FabCode288/HSK-Mensabot/docs/source/packages/mensabot_utils/safety/safety_control_node.rst

Safety Control Node
===================

The ``SafetyControlNode`` is the central software safety component of the HSK-MensaBot. It supervises the current safety state of the robot by combining information from the safety laser scanners, the hardware interface and the emergency stop circuit.

Based on the current operating state, the node publishes speed limitations, emergency stop information and filtered velocity commands. In addition, it performs the automatic reset of the safety relay once all safety conditions have returned to a valid state.

Purpose
-------

The node performs the following safety-related tasks:

* Monitors the front and rear safety laser scanners.
* Evaluates warning and protective field violations.
* Supervises the hardware connection state.
* Monitors the emergency stop relay.
* Automatically resets the safety relay after a valid release.
* Limits the maximum driving speed inside warning fields.
* Stops all robot motion during emergency stop conditions.
* Publishes the current emergency stop state for other software components.

Subscribed Topics
-----------------

+---------------------------------+---------------------------------------------+-------------------------------------------------------------------------+
| Topic                           | Message Type                                | Description                                                             |
+=================================+=============================================+=========================================================================+
| ``/lidars/front/output_paths``  | ``sick_safetyscanners2_interfaces/OutputPaths`` | Front safety scanner monitoring information.                        |
+---------------------------------+---------------------------------------------+-------------------------------------------------------------------------+
| ``/lidars/rear/output_paths``   | ``sick_safetyscanners2_interfaces/OutputPaths`` | Rear safety scanner monitoring information.                         |
+---------------------------------+---------------------------------------------+-------------------------------------------------------------------------+
| ``/hardware/connected``         | ``std_msgs/Bool``                           | Indicates whether communication with the motor controller is available. |
+---------------------------------+---------------------------------------------+-------------------------------------------------------------------------+
| ``/cmd_vel``                    | ``geometry_msgs/Twist``                     | Incoming velocity commands generated by the navigation stack.           |
+---------------------------------+---------------------------------------------+-------------------------------------------------------------------------+

Published Topics
----------------

+----------------------+-----------------------------+------------------------------------------------------------+
| Topic                | Message Type                | Description                                                |
+======================+=============================+============================================================+
| ``/speed_limit``     | ``nav2_msgs/SpeedLimit``    | Current speed limitation used by the navigation stack.     |
+----------------------+-----------------------------+------------------------------------------------------------+
| ``/safety/estop``    | ``std_msgs/Bool``           | Current emergency stop state.                              |
+----------------------+-----------------------------+------------------------------------------------------------+
| ``/safety/cmd_vel``  | ``geometry_msgs/Twist``     | Safety-filtered velocity commands forwarded to the robot.  |
+----------------------+-----------------------------+------------------------------------------------------------+

Parameters
----------

+----------------+---------+-----------------------------------------------------------------------------------------+
| Parameter      | Default | Description                                                                             |
+================+=========+=========================================================================================+
| ``simulation`` | ``false`` | Enables simulation mode by disabling GPIO access and hardware-specific functionality. |
+----------------+---------+-----------------------------------------------------------------------------------------+

Related Documentation
---------------------

The overall safety architecture, hardware safety circuit and software safety concept are described in the project documentation.

Project Documentation

`Safety Documentation <https://github.com/FabCode288/HSK-Mensabot/blob/main/docs/safety/README.md>`_

Repository

`Safety Control Node <https://github.com/FabCode288/HSK-Mensabot/blob/main/src/mensabot_utils/mensabot_utils/safety_control_node.py>`_

API Reference
-------------

.. automodule:: mensabot_utils.safety_control_node
   :members:
   :undoc-members:
   :show-inheritance:
