FabCode288/HSK-Mensabot/docs/source/index.rst

.. Mensabot documentation master file, created by
   sphinx-quickstart on Wed Jul 29 22:39:57 2026.
   You can adapt this file completely to your liking, but it should at least
   contain the root `toctree` directive.

Mensabot Documentation
======================

Welcome to the documentation of the HSK-Mensabot project.

This documentation contains the project description and launch files as well as the complete Python and C++ API documentation.



   Overview of the Mensabot in the simulation environment.



   Overview of the Mensabot in the real environment.

.. toctree::
   :maxdepth: 2
   :caption: User Guide

   user_guide
   introduction
   installation
   quick_start
   architecture

.. toctree::
   :maxdepth: 2
   :caption: API Reference

   api_reference
   packages/index

.. toctree::
   :maxdepth: 2
   :caption: Developer Guide

   developer_guide
   repository
   build
   documentation
