FabCode288/HSK-Mensabot/src/sick_safetyscanners2/docs/images/safetyscanners.png

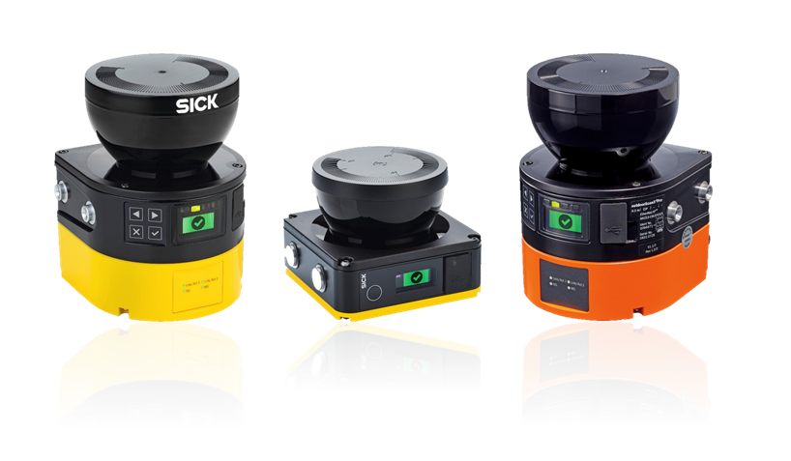
src/sick_safetyscanners2/docs/images/safetyscanners.png
