FabCode288/HSK-Mensabot/src/sick_safetyscanners_base/docs/images/safetyscanners.png

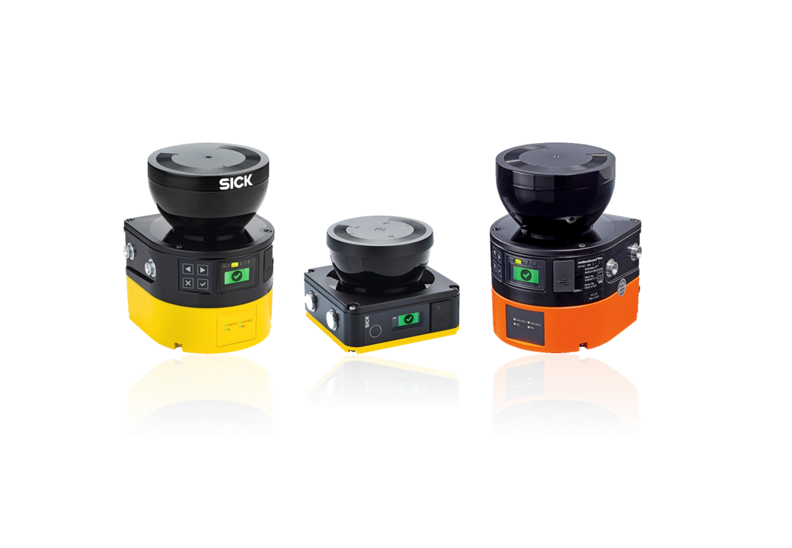
src/sick_safetyscanners_base/docs/images/safetyscanners.png
