FabCode288/HSK-Mensabot/src/sick_safetyscanners2/description/meshes/NANS3_collision.stl

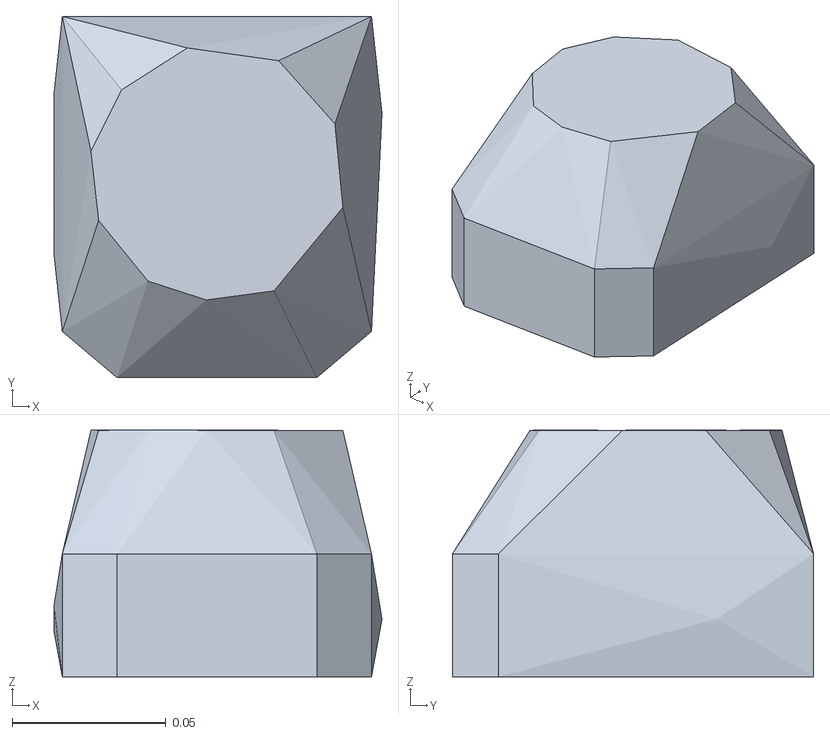
[picture p57: CAD file, 2026-05-12]
src/sick_safetyscanners2/description/meshes/NANS3_collision.stl
0.107 x 0.117 x 0.0802
