FabCode288/HSK-Mensabot/src/sick_safetyscanners2/description/meshes/MountingKit_2a_collision.stl

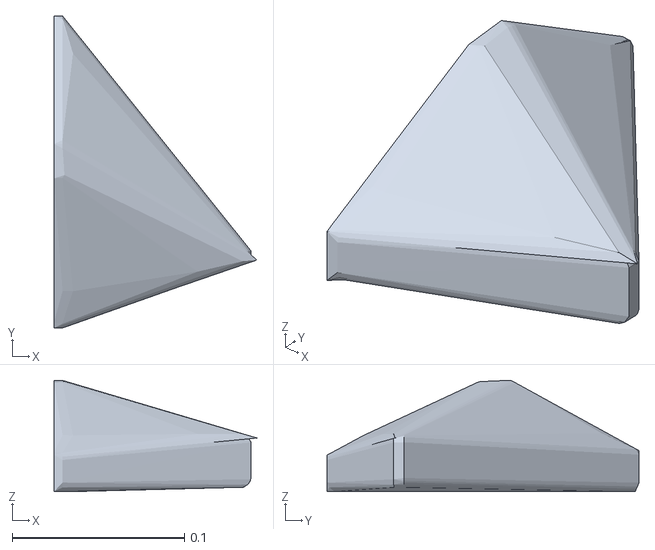
[picture p58: CAD file, 2026-05-12]
src/sick_safetyscanners2/description/meshes/MountingKit_2a_collision.stl
0.118 x 0.181 x 0.0645
