FabCode288/HSK-Mensabot/docs/images/tf_tree.pdf

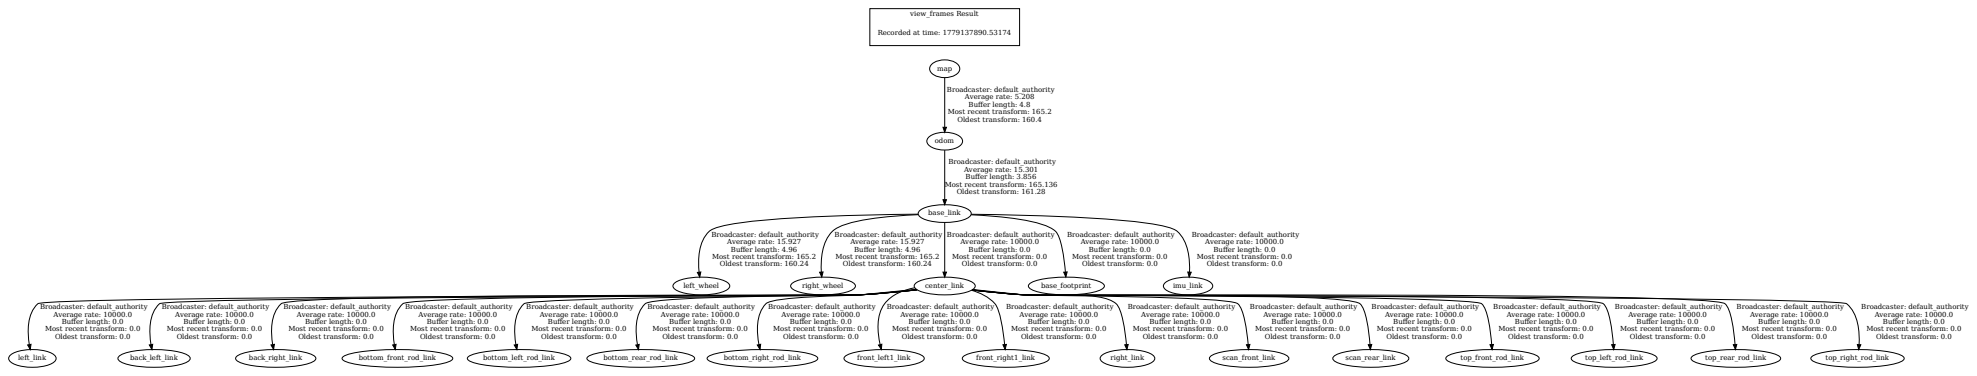
[picture p59: page 1]
view_frames Result; base_link; left_wheel; right_wheel; center_link; base_footprint; imu_link; odom; left_link; back_left_link; back_right_link; bottom_front_rod_link; bottom_left_rod_link; bottom_rear_rod_link; bottom_right_rod_link; front_left1_link; front_right1_link; right_link; scan_front_link; scan_rear_link; top_front_rod_link; top_left_rod_link; top_rear_rod_link; top_right_rod_link; map

Recorded at time: 1779137890.53174

Broadcaster: default_authority
Average rate: 5.208
Buffer length: 4.8
Most recent transform: 165.2
Oldest transform: 160.4

Average rate: 15.301
Buffer length: 3.856
Most recent transform: 165.136
Oldest transform: 161.28

Average rate: 15.927
Buffer length: 4.96
Oldest transform: 160.24

Average rate: 10000.0
Buffer length: 0.0
Most recent transform: 0.0
Oldest transform: 0.0
