FabCode288/HSK-Mensabot/src/mensabot_navigation/config/navigation.yaml

bt_navigator:
  ros__parameters:
    global_frame: map
    robot_base_frame: base_footprint # changed from base_footprint
    odom_topic: /odom
    bt_loop_duration: 10
    default_server_timeout: 20
    wait_for_service_timeout: 1000
    action_server_result_timeout: 900.0
    navigators: ["navigate_to_pose", "navigate_through_poses"]
    navigate_to_pose:
      plugin: "nav2_bt_navigator::NavigateToPoseNavigator"
    navigate_through_poses:
      plugin: "nav2_bt_navigator::NavigateThroughPosesNavigator"

    error_code_names:
      - compute_path_error_code
      - follow_path_error_code

controller_server:
  ros__parameters:
    controller_frequency: 20.0
    costmap_update_timeout: 0.30
    min_x_velocity_threshold: 0.001
    min_y_velocity_threshold: 0.0 
    min_theta_velocity_threshold: 0.001
    speed_limit_topic: "/speed_limit"
    failure_tolerance: 0.3
    progress_checker_plugins: ["progress_checker"]
    goal_checker_plugins: ["general_goal_checker"] # "precise_goal_checker"
    controller_plugins: ["FollowPath"]
    use_realtime_priority: false

    # Progress checker parameters
    progress_checker:
      plugin: "nav2_controller::SimpleProgressChecker"
      required_movement_radius: 0.1 #changed from 0.05 #1.0
      movement_time_allowance: 20.0 #changed from 30.0 #12.0

    general_goal_checker:
      stateful: True
      plugin: "nav2_controller::SimpleGoalChecker"
      xy_goal_tolerance: 0.10 #changed from 0.15
      yaw_goal_tolerance: 0.10 #changed from 0.15

    # MPPI parameters
    FollowPath:
      plugin: "nav2_mppi_controller::MPPIController"
      time_steps: 100 #80
      model_dt: 0.05
      batch_size: 1000 #800 #2000 @ 30 Hz or 1000 @ 50 Hz are good values
      ax_max: 4.0 #m/s^2
      ax_min: -4.0 #m/s^2
      ay_max: 0.0 #No motion in y direction
      az_max: 4.0 #No motion in z direction
      vx_std: 0.2
      vy_std: 0.2
      wz_std: 0.2 
      vx_max: 0.5 #m/s
      vx_min: -0.5 #m/s
      vy_max: 0.0 #No motion in y direction
      wz_max: 0.5 #rad/s
      iteration_count: 1
      prune_distance: 1.7
      transform_tolerance: 0.1
      temperature: 0.3
      gamma: 0.015 #Usually not needed to change gamma
      motion_model: "DiffDrive"
      visualize: true #turn false for better performance, true for debugging
      regenerate_noises: true
      open_loop: false #false for using odometry feedback, true for using last command velocities as input to the model
      TrajectoryVisualizer:
        trajectory_step: 5
        time_step: 3
      critics: [
        "ConstraintCritic", "CostCritic", "GoalCritic",
        "GoalAngleCritic", "PathAlignCritic", "PathFollowCritic",
        "PathAngleCritic", "PreferForwardCritic"]
      ConstraintCritic:
        enabled: true
        cost_power: 1
        cost_weight: 4.0
      GoalCritic:
        enabled: true
        cost_power: 2 #1
        cost_weight: 6.0
        threshold_to_consider: 2.0
      GoalAngleCritic:
        enabled: true
        cost_power: 1
        cost_weight: 4.0
        threshold_to_consider: 0.8 #0.8
      PreferForwardCritic:
        enabled: true
        cost_power: 1
        cost_weight: 8.0 #5
        threshold_to_consider: 0.5
      CostCritic:
        enabled: true
        cost_power: 1
        cost_weight: 3.81
        critical_cost: 300.0
        consider_footprint: true
        collision_cost: 1000000.0
        near_goal_distance: 0.5 #1.0
        trajectory_point_step: 2
      PathAlignCritic:
        enabled: true
        cost_power: 1
        cost_weight: 14.0
        max_path_occupancy_ratio: 0.05
        trajectory_point_step: 4
        threshold_to_consider: 0.5
        offset_from_furthest: 20
        use_path_orientations: false
      PathFollowCritic:
        enabled: true
        cost_power: 1
        cost_weight: 5.0
        offset_from_furthest: 6
        threshold_to_consider: 2.0
      PathAngleCritic:
        enabled: true
        cost_power: 1
        cost_weight: 2.0
        offset_from_furthest: 4
        threshold_to_consider: 0.5
        max_angle_to_furthest: 1.0
        mode: 0
      VelocityDeadbandCritic:
         enabled: true
         cost_power: 1
         cost_weight: 35.0
         deadband_velocities: [0.5, 0.0, 0.5]
      # TwirlingCritic:
      #   enabled: true
      #   twirling_cost_power: 1
      #   twirling_cost_weight: 10.0

local_costmap:
  local_costmap:
    ros__parameters:
      update_frequency: 5.0
      publish_frequency: 2.0
      global_frame: odom
      robot_base_frame: base_footprint
      rolling_window: true
      width: 5
      height: 5 
      resolution: 0.05
      footprint: "[ [0.2, 0.35], [0.2, -0.35], [-0.65, -0.35], [-0.65, 0.35] ]"
      plugins: ["voxel_layer", "inflation_layer"]
      inflation_layer:
        plugin: "nav2_costmap_2d::InflationLayer"
        cost_scaling_factor: 3.0
        inflation_radius: 1.2
      voxel_layer:
        plugin: "nav2_costmap_2d::VoxelLayer"
        enabled: True
        publish_voxel_map: True
        origin_z: 0.0
        z_resolution: 0.05
        z_voxels: 16
        max_obstacle_height: 2.0
        mark_threshold: 0
        observation_sources: scan
        scan:
          topic: /merged_scan
          max_obstacle_height: 2.0
          clearing: True
          marking: True
          data_type: "LaserScan"
          raytrace_max_range: 5.0
          raytrace_min_range: 0.0
          obstacle_max_range: 4.5
          obstacle_min_range: 0.0
      static_layer:
        plugin: "nav2_costmap_2d::StaticLayer"
        map_subscribe_transient_local: True
      always_send_full_costmap: True

global_costmap:
  global_costmap:
    ros__parameters:
      update_frequency: 1.0
      publish_frequency: 1.0
      global_frame: map
      robot_base_frame: base_footprint
      footprint: "[ [0.2, 0.35], [0.2, -0.35], [-0.65, -0.35], [-0.65, 0.35] ]"
      resolution: 0.05
      track_unknown_space: true
      plugins: ["static_layer", "obstacle_layer", "inflation_layer"]
      obstacle_layer:
        plugin: "nav2_costmap_2d::ObstacleLayer"
        enabled: True
        observation_sources: scan
        scan:
          topic: /merged_scan
          max_obstacle_height: 2.0
          clearing: True
          marking: True
          data_type: "LaserScan"
          raytrace_max_range: 5.0
          raytrace_min_range: 0.0
          obstacle_max_range: 4.5
          obstacle_min_range: 0.0
      static_layer:
        plugin: "nav2_costmap_2d::StaticLayer"
        map_subscribe_transient_local: True
      inflation_layer:
        plugin: "nav2_costmap_2d::InflationLayer"
        cost_scaling_factor: 3.0
        inflation_radius: 1.2
      always_send_full_costmap: True


planner_server:
  ros__parameters:
    expected_planner_frequency: 20.0
    planner_plugins: ["GridBased"]
    costmap_update_timeout: 1.0
    GridBased:
      plugin: "nav2_navfn_planner::NavfnPlanner"
      tolerance: 0.5
      use_astar: false
      allow_unknown: true

smoother_server:
  ros__parameters:
    smoother_plugins: ["simple_smoother"]
    simple_smoother:
      plugin: "nav2_smoother::SimpleSmoother"
      tolerance: 1.0e-10
      max_its: 1000
      do_refinement: True

behavior_server:
  ros__parameters:
    local_costmap_topic: local_costmap/costmap_raw
    global_costmap_topic: global_costmap/costmap_raw
    local_footprint_topic: local_costmap/published_footprint
    global_footprint_topic: global_costmap/published_footprint
    cycle_frequency: 10.0
    behavior_plugins: ["spin", "backup", "drive_on_heading", "assisted_teleop", "wait"]
    spin:
      plugin: "nav2_behaviors::Spin"
      max_rotational_vel: 0.5
      min_rotational_vel: 0.05
      rotational_acc_lim: 0.5
      enable_stamped_cmd_vel: true 
    backup:
      plugin: "nav2_behaviors::BackUp"
    drive_on_heading:
      plugin: "nav2_behaviors::DriveOnHeading"
    wait:
      plugin: "nav2_behaviors::Wait"
    assisted_teleop:
      plugin: "nav2_behaviors::AssistedTeleop"
    local_frame: odom
    global_frame: map
    robot_base_frame: base_footprint
    transform_tolerance: 0.1
    simulate_ahead_time: 2.0
    max_rotational_vel: 1.0
    min_rotational_vel: 0.4
    rotational_acc_lim: 3.2

waypoint_follower:
  ros__parameters:
    loop_rate: 20
    stop_on_failure: false
    action_server_result_timeout: 900.0
    waypoint_task_executor_plugin: "wait_at_waypoint"
    wait_at_waypoint:
      plugin: "nav2_waypoint_follower::WaitAtWaypoint"
      enabled: True
      waypoint_pause_duration: 200

velocity_smoother:
  ros__parameters:
    smoothing_frequency: 20.0
    scale_velocities: False
    feedback: "OPEN_LOOP"
    max_velocity: [0.5, 0.0, 0.5]
    min_velocity: [-0.5, 0.0, -0.5]
    max_accel: [0.4, 0.0, 0.8]
    max_decel: [-0.6, 0.0, -0.8]
    odom_topic: "odom"
    odom_duration: 0.1
    deadband_velocity: [0.0, 0.0, 0.0]
    velocity_timeout: 1.0

collision_monitor:
  ros__parameters:
    base_frame_id: "base_footprint" #changed from base_footprint
    odom_frame_id: "odom"
    cmd_vel_in_topic: "cmd_vel_smoothed"
    cmd_vel_out_topic: "cmd_vel"
    state_topic: "collision_monitor_state"
    transform_tolerance: 0.2
    source_timeout: 1.0
    base_shift_correction: True
    stop_pub_timeout: 2.0
    # Polygons represent zone around the robot for "stop", "slowdown" and "limit" action types,
    # and robot footprint for "approach" action type.
    polygons: ["FootprintApproach"]
    FootprintApproach:
      type: "polygon"
      action_type: "approach"
      footprint_topic: "/local_costmap/published_footprint"
      time_before_collision: 1.2
      simulation_time_step: 0.1
      min_points: 6
      visualize: False
      enabled: True
    observation_sources: ["scan"]
    scan:
      type: "scan"
      topic: "/merged_scan" # changed from "merged_scan"
      min_height: 0.15
      max_height: 2.0
      enabled: True

docking_server:
  ros__parameters:
    controller_frequency: 50.0
    initial_perception_timeout: 5.0
    wait_charge_timeout: 5.0
    dock_approach_timeout: 30.0
    undock_linear_tolerance: 0.05
    undock_angular_tolerance: 0.1
    max_retries: 3
    base_frame: "base_footprint"
    fixed_frame: "odom"
    dock_backwards: false
    dock_prestaging_tolerance: 0.5

    # Types of docks
    dock_plugins: ['simple_charging_dock']
    simple_charging_dock:
      plugin: 'opennav_docking::SimpleChargingDock'
      docking_threshold: 0.05
      staging_x_offset: -0.7
      use_external_detection_pose: true
      use_battery_status: false # true
      use_stall_detection: false # true

      external_detection_timeout: 1.0
      external_detection_translation_x: -0.18
      external_detection_translation_y: 0.0
      external_detection_rotation_roll: -1.57
      external_detection_rotation_pitch: -1.57
      external_detection_rotation_yaw: 0.0
      filter_coef: 0.1

    controller:
      k_phi: 3.0
      k_delta: 2.0
      v_linear_min: 0.15
      v_linear_max: 0.15
