FabCode288/HSK-Mensabot/src/mensabot_utils/mensabot_utils/lidar_field_selection_node.py

#!/usr/bin/env python3

"""
Selects the active LiDAR monitoring field based on the robot's motion state.

The node evaluates the commanded robot motion, selects the corresponding
LiDAR monitoring field, updates the GPIO outputs for the safety scanner and
publishes the matching Nav2 footprint.
"""

import rclpy
from rclpy.node import Node

from geometry_msgs.msg import TwistStamped, Polygon, Point32
from std_msgs.msg import String
from std_msgs.msg import Bool

from enum import Enum


class FieldState(Enum):
    """
    Enumeration of all supported LiDAR monitoring states.
    """

    STOP = 0

    FORWARD = 1
    BACKWARD = 2

    ROTATE_LEFT = 3
    ROTATE_RIGHT = 4

    MANUAL_OVERRIDE = 5


class LidarFieldSelector(Node):
    """
    ROS 2 node for selecting LiDAR monitoring fields.

    The node determines the robot's current motion state from velocity commands,
    controls the LiDAR field selection via GPIO outputs and updates the dynamic
    Nav2 footprint accordingly.
    """

    def __init__(self):
        """
        Initialize parameters, GPIO interfaces, ROS interfaces and internal state.
        """
        super().__init__('lidar_field_selector')

        # ============================================================
        # PARAMETERS
        # ============================================================

        self.declare_parameter('simulation', True)

        self.simulation = self.get_parameter(
            'simulation'
        ).get_parameter_value().bool_value

        # ============================================================
        # GPIO CONFIG
        # ============================================================

        self.gpio_pins = [22, 23, 24, 25, 26, 27]
        self.gpio_available = False

        self.gpio_requests = {}

        # Import GPIO ONLY on Raspberry Pi / real robot
        if not self.simulation:

            try:

                import gpiod  # type: ignore
                from gpiod.line import Direction, Value  # type: ignore

                self.gpiod = gpiod
                self.Direction = Direction
                self.Value = Value

                self.gpio_chip_path = "/dev/gpiochip4"

                for pin in self.gpio_pins:

                    gpio_request = self.gpiod.request_lines(
                        self.gpio_chip_path,
                        consumer="lidar_field_selector",
                        config={
                            pin:
                            self.gpiod.LineSettings(
                                direction=self.Direction.OUTPUT
                            )
                        }
                    )

                    self.gpio_requests[pin] = gpio_request

                    # Initialize HIGH
                    gpio_request.set_value(
                        pin,
                        self.Value.ACTIVE
                    )

                self.gpio_available = True

                self.get_logger().info(
                    'GPIO initialized'
                )

            except Exception as e:

                self.get_logger().error(
                    f'GPIO initialization failed: {e}'
                )

        else:

            self.get_logger().info(
                'Simulation mode active -> GPIO disabled'
            )

        # ============================================================
        # CONFIG
        # ============================================================

        self.linear_threshold = 0.02
        self.angular_threshold = 0.05

        self.timeout_sec = 0.5

        self.manual_override_timeout_sec = 2.0

        # ============================================================
        # FOOTPRINT CONFIGURATION
        # ============================================================

        # Original robot footprint:
        #
        # Front:  x =  0.20 m
        # Rear:   x = -0.65 m
        # Left:   y =  0.35 m
        # Right:  y = -0.35 m
        #
        # The following footprints include the additional safety
        # distances for the corresponding lidar monitoring case.

        self.footprints = {

            # --------------------------------------------------------
            # FORWARD
            #
            # Front: +300 mm
            # Rear:  +200 mm
            # Left:  +100 mm
            # Right: +100 mm
            # --------------------------------------------------------

            FieldState.FORWARD: [
                [0.55, 0.45],
                [0.55, -0.45],
                [-0.80, -0.45],
                [-0.80, 0.45],
            ],

            # --------------------------------------------------------
            # BACKWARD
            #
            # Front: +200 mm
            # Rear:  +300 mm
            # Left:  +100 mm
            # Right: +100 mm
            # --------------------------------------------------------

            FieldState.BACKWARD: [
                [0.40, 0.45],
                [0.40, -0.45],
                [-1.0, -0.45],
                [-1.0, 0.45],
            ],

            # --------------------------------------------------------
            # ROTATE LEFT
            #
            # Base extension:
            # Front: +200 mm
            # Rear:  +200 mm
            # Left:  +100 mm
            # Right: +100 mm
            #
            # Additional extension at rear right:
            # Right rear corner: -300 mm additional
            # --------------------------------------------------------

            FieldState.ROTATE_LEFT: [
                [0.40, -0.45],
                [0.40, 0.45],
                [0.00, 0.45],
                [-0.40, 0.75],
                [-0.85, 0.25],
                [-0.85, -0.45],
            ],

            # --------------------------------------------------------
            # ROTATE RIGHT
            #
            # Base extension:
            # Front: +200 mm
            # Rear:  +200 mm
            # Left:  +100 mm
            # Right: +100 mm
            #
            # Additional extension at rear left:
            # Left rear corner: +300 mm additional
            # --------------------------------------------------------

            FieldState.ROTATE_RIGHT: [
                [0.40, 0.45],
                [0.40, -0.45],
                [0.00, -0.45],
                [-0.70, -0.75],
                [-0.85, -0.25],
                [-0.85, 0.45],
            ],

            # --------------------------------------------------------
            # STOP
            #
            # Front: +200 mm
            # Rear:  +200 mm
            # Left:  +100 mm
            # Right: +100 mm
            # --------------------------------------------------------

            FieldState.STOP: [
                [0.40, 0.45],
                [0.40, -0.45],
                [-0.85, -0.45],
                [-0.85, 0.45],
            ],

            # --------------------------------------------------------
            # MANUAL OVERRIDE
            #
            # Uses STOP footprint for Nav2 collision checking.
            # --------------------------------------------------------

            FieldState.MANUAL_OVERRIDE: [
                [0.40, 0.45],
                [0.40, -0.45],
                [-0.85, -0.45],
                [-0.85, 0.45],
            ],
        }

        # ============================================================
        # STATE
        # ============================================================

        self.current_state = FieldState.STOP

        self.last_cmd_time = self.get_clock().now()

        self.manual_override_active = False

        self.last_manual_override_msg_time = self.get_clock().now()

        # ============================================================
        # ROS INTERFACES
        # ============================================================

        self.cmd_vel_sub = self.create_subscription(
            TwistStamped,
            '/mensabot_base_controller/cmd_vel_out',
            self.cmd_vel_callback,
            10
        )

        self.manual_override_sub = self.create_subscription(
            Bool,
            '/safety/manual_override',
            self.manual_override_callback,
            10
        )

        self.field_state_pub = self.create_publisher(
            String,
            '/safety/field_state',
            10
        )

        # Dynamic Nav2 local costmap footprint
        self.footprint_pub = self.create_publisher(
            Polygon,
            '/local_costmap/footprint',
            10
        )

        self.timer = self.create_timer(
            0.1,
            self.timer_callback
        )

        self.get_logger().info(
            'Lidar field selector started'
        )

        # Publish initial state
        self.publish_state()

        # Set initial lidar monitoring field
        self.set_gpio_state()

        # Publish initial STOP footprint
        self.publish_footprint()

    # ============================================================
    # MANUAL OVERRIDE CALLBACK
    # ============================================================

    def manual_override_callback(self, msg: Bool):
        """
        Handle manual override requests.

        Args:
            msg: Manual override state.
        """

        self.last_manual_override_msg_time = self.get_clock().now()

        previous_state = self.manual_override_active

        self.manual_override_active = msg.data

        if self.manual_override_active and not previous_state:

            self.get_logger().warn(
                'MANUAL OVERRIDE ACTIVE'
            )

        if self.manual_override_active:

            if self.current_state != FieldState.MANUAL_OVERRIDE:

                self.current_state = FieldState.MANUAL_OVERRIDE

                self.publish_state()

                self.set_gpio_state()

                self.publish_footprint()

    # ============================================================
    # CMD VEL CALLBACK
    # ============================================================

    def cmd_vel_callback(self, msg: TwistStamped):
        """
        Process commanded robot velocities and update the active monitoring field.

        Args:
            msg: Commanded robot velocity.
        """

        self.last_cmd_time = self.get_clock().now()

        if self.manual_override_active:
            return

        linear_x = msg.twist.linear.x
        angular_z = msg.twist.angular.z

        # Deadband
        if abs(linear_x) < self.linear_threshold:
            linear_x = 0.0

        if abs(angular_z) < self.angular_threshold:
            angular_z = 0.0

        new_state = self.determine_state(
            linear_x,
            angular_z
        )

        # Only switch field and footprint if state changed
        if new_state != self.current_state:

            self.current_state = new_state

            self.publish_state()

            self.set_gpio_state()

            self.publish_footprint()

    # ============================================================
    # DETERMINE STATE
    # ============================================================

    def determine_state(
        self,
        linear_x: float,
        angular_z: float
    ) -> FieldState:
        """
        Determine the LiDAR monitoring state from the commanded motion.

        Args:
            linear_x: Linear velocity in x-direction.
            angular_z: Angular velocity around the z-axis.

        Returns:
            FieldState: Selected monitoring state.
        """

        # STOP
        if linear_x == 0.0 and angular_z == 0.0:
            return FieldState.STOP

        # PURE FORWARD / BACKWARD
        if linear_x > 0.0 and angular_z == 0.0:
            return FieldState.FORWARD

        if linear_x < 0.0 and angular_z == 0.0:
            return FieldState.BACKWARD

        # PURE ROTATION
        if linear_x == 0.0 and angular_z < 0.0:
            return FieldState.ROTATE_LEFT

        if linear_x == 0.0 and angular_z > 0.0:
            return FieldState.ROTATE_RIGHT

        # COMBINED MOVEMENT
        if abs(linear_x) < 0.15 and angular_z < -0.3:
            return FieldState.ROTATE_LEFT

        if abs(linear_x) < 0.15 and angular_z > 0.3:
            return FieldState.ROTATE_RIGHT

        # Forward / Backward has priority

        if linear_x > 0.0:
            return FieldState.FORWARD

        if linear_x < 0.0:
            return FieldState.BACKWARD

        return FieldState.STOP

    # ============================================================
    # FOOTPRINT PUBLISHER
    # ============================================================

    def publish_footprint(self):
        """
        Publish the footprint corresponding to the current monitoring state.
        """

        footprint_points = self.footprints.get(
            self.current_state
        )

        if footprint_points is None:

            self.get_logger().error(
                f'No footprint defined for state: '
                f'{self.current_state.name}'
            )

            return

        polygon = Polygon()

        for x, y in footprint_points:

            point = Point32()

            point.x = float(x)
            point.y = float(y)
            point.z = 0.0

            polygon.points.append(point)

        self.footprint_pub.publish(polygon)

        self.get_logger().info(
            f'Published footprint for state: '
            f'{self.current_state.name}'
        )

    # ============================================================
    # GPIO OUTPUT
    # ============================================================

    def set_gpio_state(self):
        """
        Update the GPIO outputs according to the selected monitoring field.
        """

        self.get_logger().info(
            f'Field state: {self.current_state.name}'
        )

        if not self.gpio_available:
            return

        # Set all outputs HIGH
        for pin in self.gpio_pins:

            self.gpio_requests[pin].set_value(
                pin,
                self.Value.ACTIVE
            )

        active_pin = None

        if self.current_state == FieldState.FORWARD:
            active_pin = 22

        elif self.current_state == FieldState.BACKWARD:
            active_pin = 23

        elif self.current_state == FieldState.ROTATE_LEFT:
            active_pin = 24

        elif self.current_state == FieldState.ROTATE_RIGHT:
            active_pin = 25

        elif self.current_state == FieldState.MANUAL_OVERRIDE:
            active_pin = 26

        elif self.current_state == FieldState.STOP:
            return

        if active_pin is not None:

            self.gpio_requests[27].set_value(
                27,
                self.Value.INACTIVE
            )

            self.gpio_requests[active_pin].set_value(
                active_pin,
                self.Value.INACTIVE
            )

    # ============================================================
    # STATE PUBLISHER
    # ============================================================

    def publish_state(self):
        """
        Publish the current LiDAR monitoring state.
        """

        msg = String()

        msg.data = self.current_state.name

        self.field_state_pub.publish(msg)

    # ============================================================
    # TIMEOUT HANDLING
    # ============================================================

    def timer_callback(self):
        """
        Monitor command and manual override timeouts.

        Resets the monitoring state if no valid command or manual override message
        has been received within the configured timeout.
        """

        now = self.get_clock().now()

        # --------------------------------------------------------
        # MANUAL OVERRIDE TIMEOUT
        # --------------------------------------------------------

        manual_override_delta = (
            now - self.last_manual_override_msg_time
        ).nanoseconds / 1e9

        if self.manual_override_active:

            if (
                manual_override_delta
                > self.manual_override_timeout_sec
            ):

                self.manual_override_active = False

                self.get_logger().warn(
                    'MANUAL OVERRIDE TIMEOUT -> returning to normal field selection'
                )

                self.current_state = FieldState.STOP

                self.publish_state()

                self.set_gpio_state()

                self.publish_footprint()

        # --------------------------------------------------------
        # CMD VEL TIMEOUT
        # --------------------------------------------------------

        delta = (
            now - self.last_cmd_time
        ).nanoseconds / 1e9

        if delta > self.timeout_sec:

            if self.current_state != FieldState.STOP:

                if not self.manual_override_active:

                    self.current_state = FieldState.STOP

                    self.publish_state()

                    self.set_gpio_state()

                    self.publish_footprint()

                    self.get_logger().warn(
                        'cmd_vel timeout -> '
                        'STOP field and footprint activated'
                    )

    # ============================================================
    # CLEANUP
    # ============================================================

    def destroy_node(self):
        """
        Release GPIO resources before shutting down the node.
        """

        if self.gpio_available:

            for pin in self.gpio_pins:

                self.gpio_requests[pin].set_value(
                    pin,
                    self.Value.ACTIVE
                )

                self.gpio_requests[pin].release()

        super().destroy_node()


def main(args=None):
    """
    Start the LiDAR field selector node.

    Initializes ROS 2, spins the node and performs a clean shutdown when the node
    terminates.
    """

    rclpy.init(args=args)

    node = LidarFieldSelector()

    try:

        rclpy.spin(node)

    except KeyboardInterrupt:

        pass

    node.destroy_node()

    rclpy.shutdown()


if __name__ == '__main__':
    main()
