FabCode288/HSK-Mensabot/src/laser_scan_merger/config/laser_merger_param.yaml

# laser_scan_merger_node:
#   ros__parameters:
    # Declare laser scan topics to be subscribed here.
    # Max 9 laser scan topics
    scan_topics: ["/lidars/front/scan", "/lidars/rear/scan"]

    # reliability policy ros2 topic: 0=reliable, 1=best effort
    scan_policies: [0, 0, 0, 0, 0, 0, 0, 0, 0]

    # Declare the frame id for output scan, most likely base_link is appropriate.
    merged_frame_id: "center_link"

    tolerance: 0.01
    min_height: 0.0 # default to std::numeric_limits<double>::min() if not given
    max_height: 20.0 # default to std::numeric_limits<double>::max() if not given
    angle_min: -3.14159
    angle_max: 3.14159
    angle_increment: 0.01745
    scan_time: 0.0333
    range_min: 0.05
    range_max: 10.0 # default to std::numeric_limits<double>::max() if not given
    inf_epsilon: 1.0

    use_inf: true
    # Queue size for approximate filter
    queue_size: 20

    debug: true
    moving_frames: false
