FabCode288/HSK-Mensabot/src/mensabot_utils/mensabot_utils/lidar_reset.py

#!/usr/bin/env python3

"""
Reset the connected LiDAR sensors via a dedicated GPIO output.

The script generates a reset pulse, waits for the sensors to reboot and
terminates after the reset sequence has completed.
"""

import time
import gpiod
from gpiod.line import Direction, Value

GPIO_CHIP = "/dev/gpiochip4"
PIN = 16


def main():
    """Perform a hardware reset of the connected LiDAR sensors."""

    request = gpiod.request_lines(
        GPIO_CHIP,
        consumer="lidar_reset",
        config={
            PIN: gpiod.LineSettings(
                direction=Direction.OUTPUT,
                output_value=Value.INACTIVE,
            )
        },
    )

    # Generate a reset pulse for the connected LiDAR sensors.
    request.set_value(PIN, Value.INACTIVE)
    time.sleep(0.6)
    request.set_value(PIN, Value.ACTIVE)

    time.sleep(0.5)

    request.release()

    print("[INFO] [lidar_reset] Rebooting Lidars...")
    time.sleep(12.0)
    print("[INFO] [lidar_reset] Lidar reset complete.")


if __name__ == "__main__":
    main()
