FabCode288/HSK-Mensabot/(commit log)

2026-04-22 Restructure workspace repo
    [controller.yaml, home.sdf, materials.xacro, mensabot.ros2_control_real.xacro, mensabot.urdf.xacro, mostly_empty_world.sdf, test_world.sdf, world3.sdf]
2026-05-04 Updated Hardware_Plugin to Fail Safe Communication with UNO
    [mensabot_hardware.cpp]
2026-05-05 Small changes for the IMU
    [mensabot.urdf.xacro]
2026-05-05 Fixed TF for Real IMU
2026-05-05 Updated Real Bring up. Now there is a rudimentry working Communication to the UNO.
    [controller.yaml]
2026-05-07 Updated Launch for Real Robot. New Driver for Arduino Communication
    [controller.yaml]
2026-05-08 Updated Controller and Arduino Code for Working Driving
    [controller.yaml]
2026-05-11 Added Acceleration Ramp and Brake Ramp to ROS Controller
    [controller.yaml]
2026-05-11 Correct Driving Robot
    [controller.yaml]
2026-05-12 Updated Controller Frequency
    [controller.yaml]
2026-05-12 Removed Sick Repo Links
    [MountingKit_2a_collision.stl, NANS3_collision.stl, common.xacro, gazebo_macro.xacro, nanoscan3.urdf.xacro, nanoscan3_macro.xacro]
2026-05-13 Added launch for Safetyscanners, updated URDF for LIDAR Position
    [mensabot.urdf.xacro]
2026-05-13 Adjusted Position od Laserscanner
    [mensabot.urdf.xacro]
2026-05-13 Added small overview in the Arduino Code
2026-05-16 Updated Simualtion for new LidarPosition
    [mensabot.urdf.xacro]
2026-05-18 Updated URDF for new Position of Lidars
    [mensabot.urdf.xacro]
2026-05-20 Added Lidar Field Selction Node
2026-05-20 Updated Lidar Field Selection GPIOs
2026-05-20 Updated Topic for Safety Input from Lidar for Testing
2026-05-20 Updated prints in hardware Plugin
2026-05-20 Reduced Controller Frequncy from 50 to 30
    [controller.yaml]
2026-05-21 Fixed Arduino Code
2026-05-21 Update Lidar Topics
2026-05-21 Increased Acceleration
    [controller.yaml]
2026-05-21 Added Lidar to bringup
2026-05-21 Update URDF to Real Robot Dimnesions and Lidar Positions
    [mensabot.urdf.xacro]
2026-05-21 Corrected Path to Arduino
    [safety_control_node.py]
2026-05-21 Updated real Robot values and Topics to Simulation
    [mensabot.urdf.xacro]
2026-05-26 Added automatic Reset for Safety Relais
    [safety_control_node.py]
2026-05-26 Added Manuel Override for Recovery to select an Empty field in the lidar
2026-06-08 Added Different Case Monitoring Switches
2026-06-09 Updated Nodes for correct launch for the lidars
    [lidar_field_selection_node.py, safety_control_node.py]
2026-06-09 Changed Lidar Selction Field at Start from Forward to Stop
2026-06-10 Working Lidar field selection and startup
2026-06-10 Working Lidar Reset by Default Hardware Connection
    [lidar_field_selection_node.py, lidar_reset.py, mensabot_hardware.cpp]
2026-06-10 Updated Lidar Reset at Launch, now possible with a launch parameter
    [lidar_reset.py]
2026-06-10 Changed Topic for Lidar Selection from /safety to /mensabot_controller
2026-06-17 Updated Position of Lidar to fit scans
    [mensabot.urdf.xacro]
2026-07-07 Adaption von AMCL und Nav2 ML
2026-07-07 Improved Simualtion: Launch, Localization, Navigation
    [world_room.sdf]
2026-07-07 Updated navigation and Variable Footprint of the Robot depending on the LiDAR Field Selection
2026-07-08 Added Laser Scan Matcher to Simulation
2026-07-08 Add RF2O laser odometry package
2026-07-09 Fine workung Navigation in Simulation
    [controller.yaml]
2026-07-13 Adjustments to IMU and EKF
    [mensabot.urdf.xacro]
2026-07-13 Added Odometrie test and Updated EKF Afterwards for next test
    [controller.yaml]
2026-07-13 Deleted old simulation folder
    [controller.yaml, home.sdf, materials.xacro, mensabot.urdf.xacro, mostly_empty_world.sdf, test_world.sdf, world3.sdf]
2026-07-13 Improved EKF for better odometrie
2026-07-14 Finaly removed pld package mensabot_sim entirely
    [mensabot.urdf.xacro]
2026-07-16 New Rule for USB devices
2026-07-16 New Map 16_07
    [First EKF odometry_validation_2026_07_13.csv, Second odometry_validation_2026_07_13.csv, odometry_validation_2026_07_13.csv]
2026-07-16 Adjusted EKF
    [controller.yaml]
2026-07-20 Current version of the arduino Code for packages
2026-07-28 removed unnecessary files
    [First EKF odometry_validation_2026_07_13.csv, Second odometry_validation_2026_07_13.csv, odometry_validation_2026_07_13.csv]
2026-07-28 Changes in naming and structure
    [Default Parameter Motor Left.xml, Default Parameter Motor Right.xml, Left_Motor_Parameter_File_07_16.xml, Right_Motor_Parameter_File_07_16.xml]
2026-07-29 Lidars Readme V1
2026-07-29 Lidars Readme V2
2026-07-29 Lidars Readme V3
2026-07-29 Lidars Readme V4
2026-07-29 Lidars Readme V5
2026-07-29 Lidars Readme V6
2026-07-29 Motors Readme V1
2026-07-29 Motors Readme V2
2026-07-29 Motors Readme V3
2026-07-29 IMU Readme V1
2026-07-29 IMU Readme V2
2026-07-29 IMU Readme V3
2026-07-29 Added Dockstrings for Hardeware Plugin and URDF
    [mensabot.urdf.xacro]
2026-07-29 Corrected comments for docu
    [mensabot_hardware.cpp]
2026-07-29 Added Sphinx und Doxygen docu
2026-08-03 Error on Comment removed
    [mensabot.urdf.xacro]
2026-08-03 Increaed covarinacce for odom by 1
    [controller.yaml]
2026-08-03 Increased Frequncy of simulated lidars from 5 to 15
2026-08-04 Set Safet reset GPIO default to High
    [safety_control_node.py]
2026-08-04 Inverted Safety Reset toggle
    [safety_control_node.py]
2026-08-05 Updated Configuration for IMU
2026-08-05 Changed Pin for Relay inpu from 13 to 6
2026-08-05 Slight Chances to Navigation
    [controller.yaml]
2026-08-05 Small Changes to Odometrie
    [controller.yaml]
2026-08-06 Upadted Field selection and IMU Covarianzes
2026-08-24 Added Current Issues to Readme
