FabCode288/HSK-Mensabot/(notices)

Notices in the files:
README.md:
License: MIT
